PaulZC/Qwiic_Iridium_9603N/README.md

# Qwiic Iridium 9603N

### We've moved!

This repo has a new home over at [SparkFun](https://github.com/sparkfun/Qwiic_Iridium_9603N)

_"So long, and thanks for all the fish."_
_(Douglas Adams)_
