PaulZC/Qwiic_Iridium_9603N/Eagle/Qwiic_RockBLOCK_9603N.brd

## EAGLE design Eagle/Qwiic_RockBLOCK_9603N.brd (2019-07-08)

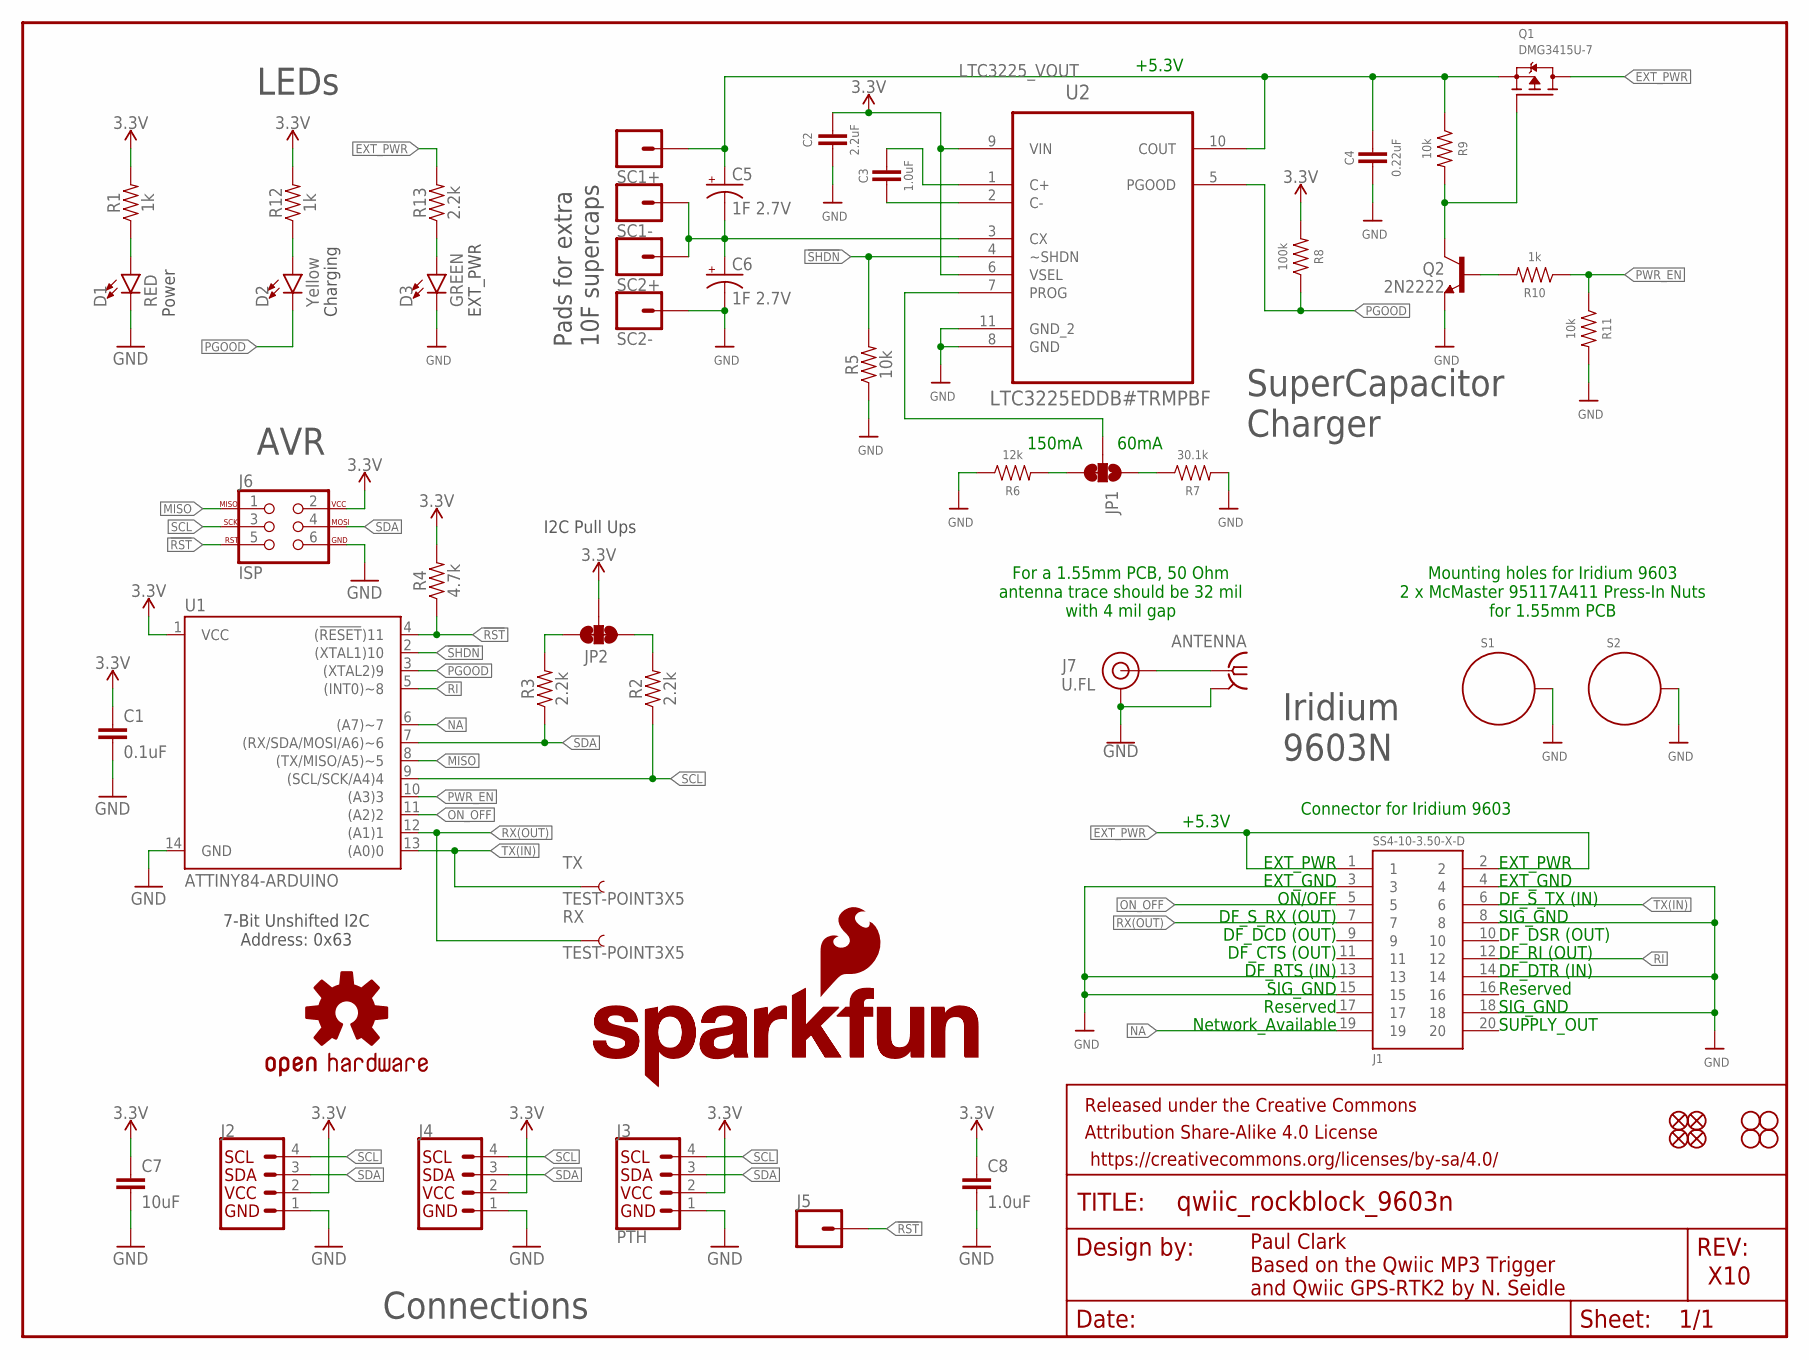
[picture p1: schematic Qwiic_RockBLOCK_9603N.sch]

Parts:
ANTENNA: SMA-142-0711-821/826; J502-ND-142-0711-821/826
C1: 0.1uF; 0603
C2: 2.2uF; 0603
C3, C8: 1.0uF; 0603
C4: 0.22uF; 0603
C5, C6: 1F 2.7V; CPOL-RADIAL-1F-2.7V
C7: 10uF; 0603
D1: RED; LED-0603
D2: Yellow; LED-0603
D3: GREEN; LED-0603
FRAME1: FRAME-LETTER; CREATIVE_COMMONS
J1: SS4-10-3.50-X-D
J2, J4: QWIIC_CONNECTORJS-1MM; 1X04_1MM_RA
J3: PTH; 1X04_NO_SILK
J5: CONN_01PTH_NO_SILK_YES_STOP; 1X01_NO_SILK
J6: ISP; 2X3_TEST_POINTS
J7: U.FL
JP1: JUMPER-PAD-3-2OF3_NC_BY_TRACE_LARGE; PAD-JUMPER-3-2OF3_NC_BY_TRACE_YES_SILK_LARGE
JP2: JUMPER-SMT_3_2-NC_TRACE_SILK; SMT-JUMPER_3_2-NC_TRACE_SILK
JP3, JP4, JP9, JP10: STAND-OFF
JP5, JP6, JP7, JP8: FIDUCIALUFIDUCIAL; MICRO-FIDUCIAL
LOGO1: OSHW-LOGOMINI; OSHW-LOGO-MINI
LOGO2: SFE_LOGO_NAME.1_INCH; SFE_LOGO_NAME_.1
LOGO3: SFE_LOGO_NAME_FLAME.1_INCH; SFE_LOGO_NAME_FLAME_.1
Q1: DMG3415U-7; SOT23-WIDE
Q2: 2N2222; SOT23-BEC
R1, R10, R12: 1k; 0603
R2, R3, R13: 2.2k; 0603
R4: 4.7k; 0603
R5, R9, R11: 10k; 0603
R6: 12k; 0603
R7: 30.1k; 0603
R8: 100k; 0603
RX: TEST-POINT3X5; PAD.03X.05
S1, S2: STANDOFF_ELECTRICALMCMASTER-95117A411; STANDOFF-ELECTRICAL-MCMASTER-95117A411
SC1+, SC1-, SC2+, SC2-: CONN_01PTH_NO_SILK_YES_STOP; 1X01_NO_SILK
TX: TEST-POINT3X5; PAD.03X.05
U1: ATTINY84-ARDUINO; SO14
U2: LTC3225EDDB#TRMPBF; DFN300X200-10L

Connections:
3.3V: C1.1, C2.1, C7.1, C8.1, J2.2, J3.2 (VCC), J4.2, J6.2, JP2.2, R1.2, R4.2, R8.2, R12.2, U1.1 (VCC), U2.6 (VSEL), U2.9 (VIN)
!RST: J5.1, J6.5, R4.1, U1.4 ((!RESET!)11)
!SHDN: R5.2, U1.2 ((XTAL1)10), U2.4 (~SHDN)
EXT_PWR: J1.1, J1.2, Q1.3 (D), R13.2
GND: ANTENNA.G@1 (2), ANTENNA.G@2 (2), ANTENNA.G@3 (2), ANTENNA.G@4 (2), C1.2, C2.2, C4.2, C6.-, C7.2, C8.2, D1.C, D3.C, J1.3, J1.4, J1.8, J1.13, J1.14, J1.15, J1.18, J2.1, J3.1 (GND), J4.1, J6.6, J7.1 (GND), J7.2 (GND), Q2.E, R5.1, R6.1, R7.2, R11.2, S1.P1, S2.P1, SC2-.1, U1.14 (GND), U2.8 (GND), U2.11 (GND_2)
LTC3225_VOUT: C4.1, C5.+, Q1.2 (S), R9.1, SC1+.1, U2.10 (COUT)
MISO: J6.1, U1.8 ((TX/MISO/A5)~5)
unnamed: C5.-, C6.+, SC1-.1, SC2+.1, U2.3 (CX)
unnamed: JP1.3, R6.2
unnamed: D1.A, R1.1
unnamed: JP1.1, R7.1
unnamed: D2.A, R12.1
unnamed: D3.A, R13.1
unnamed: ANTENNA.1, J7.FEED (SIGNAL)
unnamed: C3.2, U2.2 (C-)
unnamed: C3.1, U2.1 (C+)
unnamed: JP1.2, U2.7 (PROG)
unnamed: Q1.1 (G), Q2.C, R9.2
unnamed: Q2.B, R10.2
NA: J1.19, U1.6 ((A7)~7)
ON_OFF: J1.5, U1.11 ((A2)2)
PGOOD: D2.C, R8.1, U1.3 ((XTAL2)9), U2.5 (PGOOD)
PWR_EN: R10.1, R11.1, U1.10 ((A3)3)
RI: J1.12, U1.5 ((INT0)~8)
RX(OUT): J1.7, RX.P$1, U1.12 ((A1)1)
SCL: J2.4, J3.4 (SCL), J4.4, J6.3, R2.1, U1.9 ((SCL/SCK/A4)4)
SCL_PU1: JP2.1, R2.2
SDA: J2.3, J3.3 (SDA), J4.3, J6.4, R3.1, U1.7 ((RX/SDA/MOSI/A6)~6)
SDA_PU1: JP2.3, R3.2
TX(IN): J1.6, TX.P$1, U1.13 ((A0)0)

Notes on the sheet:
Paul Clark Based on the Qwiic MP3 Trigger and Qwiic GPS-RTK2 by N. Seidle
X10
Power
7-Bit Unshifted I2C Address: 0x63
I2C Pull Ups
AVR
Connections
Connector for Iridium 9603
EXT_PWR
EXT_GND
ON/OFF
DF_S_RX (OUT)
DF_DCD (OUT)
DF_CTS (OUT)
DF_RTS (IN)
SIG_GND
Reserved
Network_Available
DF_S_TX (IN)
DF_DSR (OUT)
DF_RI (OUT)
DF_DTR (IN)
SUPPLY_OUT
+5.3V
Mounting holes for Iridium 9603 2 x McMaster 95117A411 Press-In Nuts for 1.55mm PCB
150mA
60mA
Pads for extra 10F supercaps
SuperCapacitor Charger
Charging
Iridium 9603N
For a 1.55mm PCB, 50 Ohm antenna trace should be 32 mil with 4 mil gap
LEDs

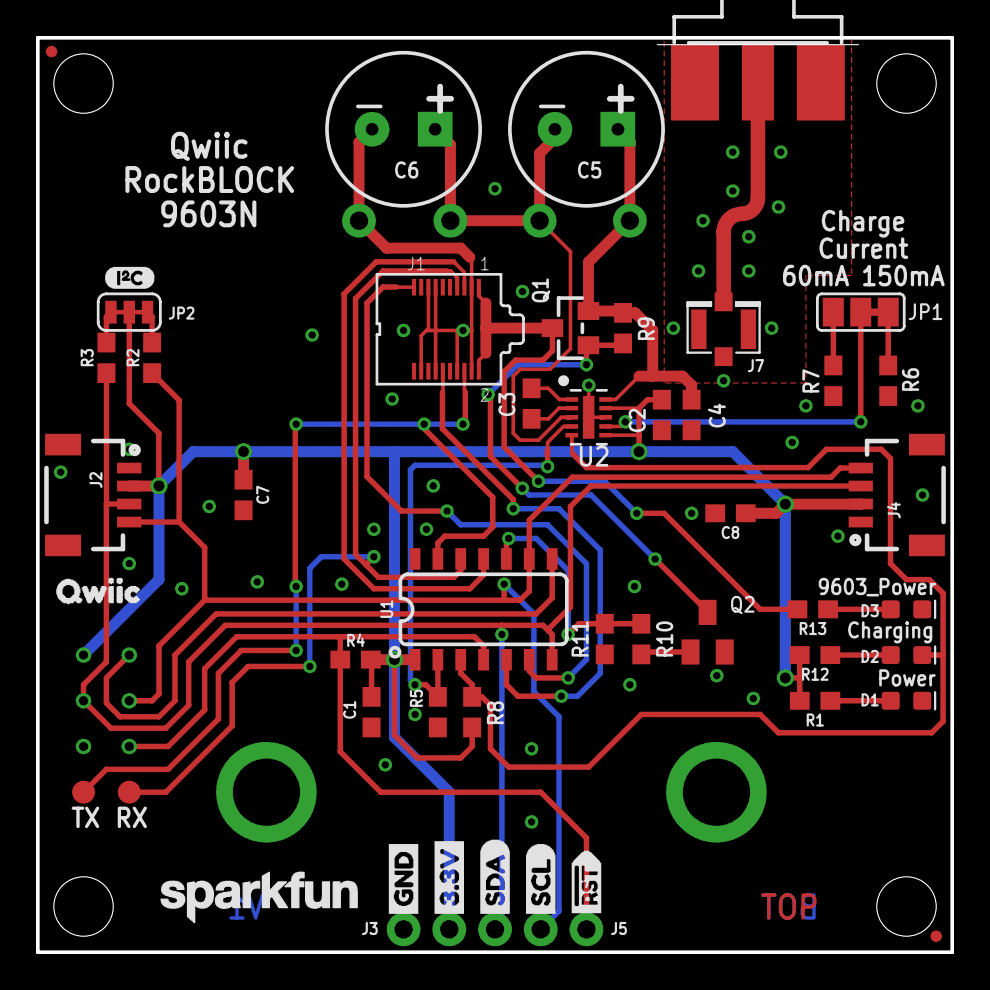
[picture p2: board Qwiic_RockBLOCK_9603N.brd from above]

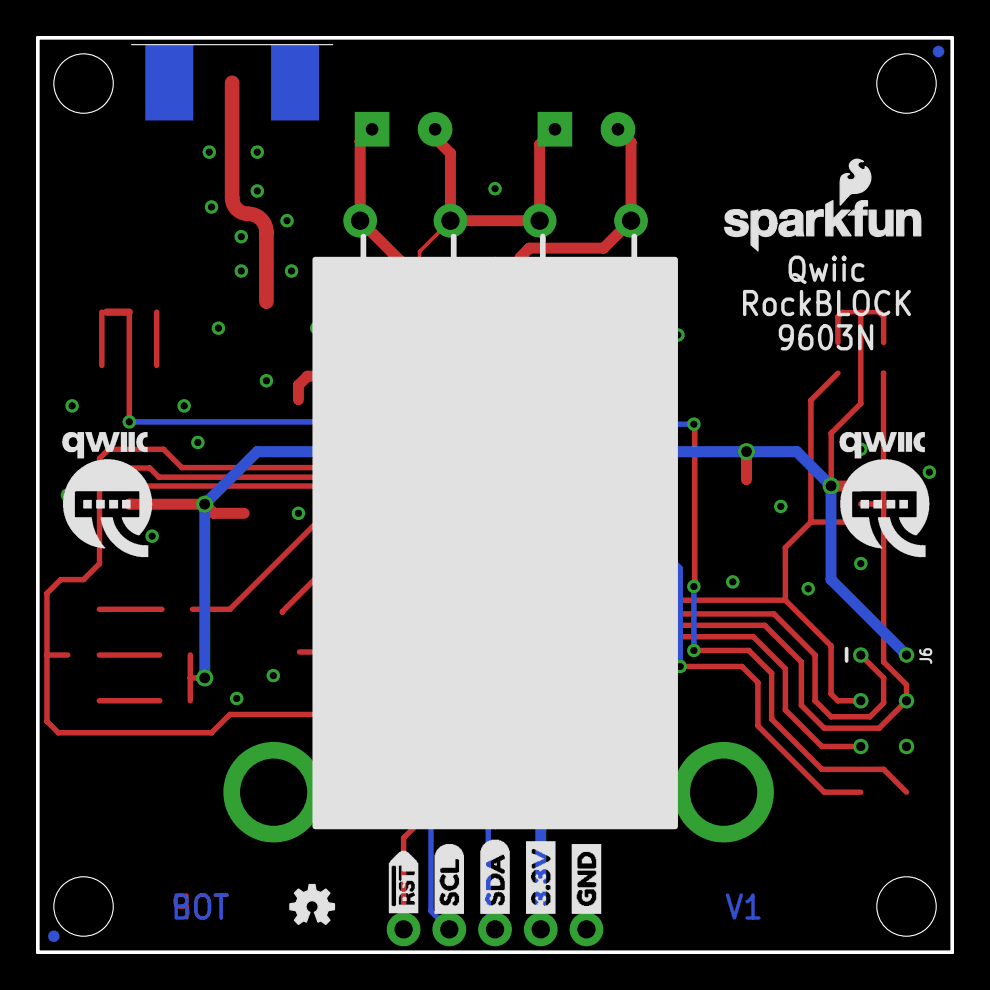
[picture p3: board Qwiic_RockBLOCK_9603N.brd from below]

Board: 2 copper layers, 50.8 x 50.8 mm, 72 parts (12 on the bottom side), 30 nets.

Other parts of the board:
U$1, U$47: QWIIC-LOGO-MEDIUM
U$3, U$22: GND1
U$4, U$21: 3#3V2
U$5, U$27: SDA8
U$6, U$26: SCL9
U$7, U$16: RST#-[>
U$8: I_SUPER2_C-()-03
U$23: QWIIC0
