PaulZC/Qwiic_Iridium_9603N/(commit log)

2019-07-08 Updated the PCB and included the Arduino code
    [Qwiic_RockBLOCK_9603N.brd, Qwiic_RockBLOCK_9603N.sch]
2019-07-15 Added the BOM
2019-07-15 Corrected the BOM file type
2019-07-17 Updates for V2 of the PCB
    [Qwiic_Iridium_9603N.brd, Qwiic_Iridium_9603N.sch]
2019-08-18 Substantial update after testing the PCB
    [Qwiic_Iridium_9603N.brd, Qwiic_Iridium_9603N.sch, Qwiic_Iridium_9603N_BOM.xlsx]
2019-08-21 Added the ADM4210
    [Qwiic_Iridium_9603N.brd, Qwiic_Iridium_9603N.sch, Qwiic_Iridium_9603N_BOM.xlsx]
2019-09-03 Added assembly details for V3 of the PCB
    [Qwiic_Iridium_9603N.brd, Qwiic_Iridium_9603N.sch, Qwiic_Iridium_9603N_BOM.xlsx]
2019-09-22 V1.1: Added the low power mode
2019-09-22 Added more assembly photos
2019-10-10 SparkX version of Qwiic Iridium
    Updated SKU's, silkscreens, and some superficial footprint changes.
    [Qwiic_Iridium_9603N-Panel-Panel.brd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]
2019-10-28 Generated PDF and cleaned up schematic
    [Qwiic_Iridium_9603N.brd, Qwiic_Iridium_9603N.sch]
2019-10-28 Updating BOM
    [Qwiic_Iridium_9603N_SparkFun_BOM.xlsx]
2020-01-15 Add ignore. Remove old backup files. Move TPs to bottom of board.
    [Qwiic_Iridium_9603N.brd, Qwiic_Iridium_9603N.sch]
2020-01-15 Update connector footprint: reduce cream, extend copper, remove extra silk.
    [Qwiic_Iridium_9603N.brd, Qwiic_Iridium_9603N.sch]
2020-01-15 Change connector to use SMD reflowable standoffs
    [Qwiic_Iridium_9603N.brd, Qwiic_Iridium_9603N.sch]
2020-01-15 Reduce cream under LTC3225 IC.
    [Qwiic_Iridium_9603N.brd, Qwiic_Iridium_9603N.sch]
2020-01-17 Reduce stopmask around connector pads. Increase standoff drill size from 3.7mm to 3.73mm.
    [Qwiic_Iridium_9603N.brd]
2020-01-21 Update modem FP with Wurth part.
    [Qwiic_Iridium_9603N.brd, Qwiic_Iridium_9603N.sch]
2020-03-22 Dereferenced the BOM
    [Qwiic_Iridium_9603N_BOM.xlsx]
2020-03-22 Updated the SMD standoffs
    Updated the Iridium 9603N and the SMD standoffs. The standoffs will now appear in the BOM.
    Updated the PROD_IDs for the New_Parts.
    The component positions should all be exactly the same, so no need to update the production panel.
    [Qwiic_Iridium_9603N.brd, Qwiic_Iridium_9603N.sch]
2020-03-25 Updated the PROD_IDs
    [Qwiic_Iridium_9603N.brd, Qwiic_Iridium_9603N.sch]
2020-05-30 Added the link to the SparkFun repo
    [Qwiic_Iridium_9603N-Panel-Panel.brd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]
